tsvetomir-zhivkov/A.L.B.E.R.T./(commit log)

2026-03-30 Add repository and controller for the sensors table and fix the createOne function
2026-03-30 Add repository and controller for the turbine_connection table; improve updateOne function in sensorController
2026-03-30 Add repository and controller for the sensor_logs; update table schema and create index on sensor_id, turbine_id and created_at
2026-04-20 Server API communication - #2 verifying sensors and inserting sensor logs
2026-04-20 Remove delay() function and use millis()
2026-04-21 Add TMC2209 stepper motor driver library
2026-04-29 Add a calibration function for the wind turbine to find the initial state
2026-05-06 Fix rotateStepperMotor() function; code refactoring
    [ALBERT.cpp, ALBERT.h]
2026-05-11 Fix bugs and code refactoring; change sensor_logs table schema
    [ALBERT.cpp, ALBERT.h]
2026-05-12 Add battery voltage sensor; Send additional data to the server
2026-05-17 Fix turbine rotation logic (angles, zones, etc.)
    [ALBERT.cpp, ALBERT.h]
2026-05-20 Fix rotating bugs when a switch is pressed; make demo version
    [ALBERT.cpp]
2026-10-16 Add battery emoji to project title in README
